Dulsika076/SLIoT-Pathfinder-GTricks/Pathfinder_Base/pcb.jpeg

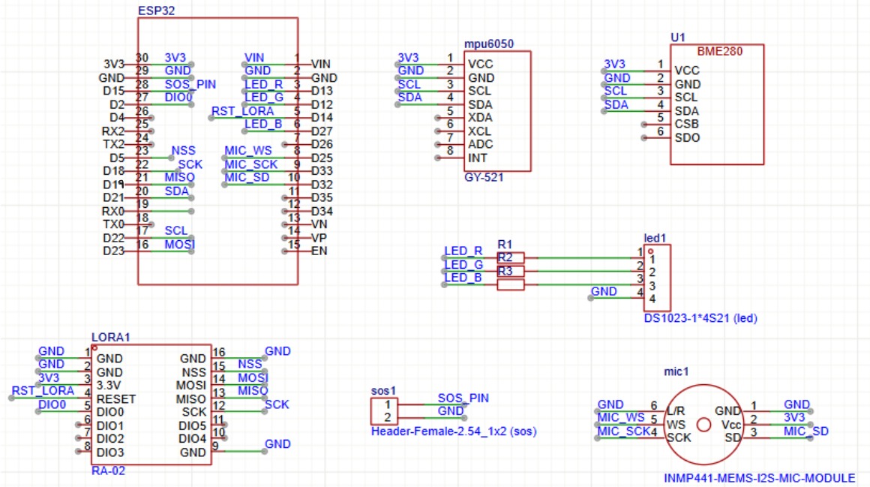
Pathfinder_Base/pcb.jpeg
