Dulsika076/SLIoT-Pathfinder-GTricks/Final/WhatsApp Image 2026-04-24 at 10.30.51 PM (1).jpeg

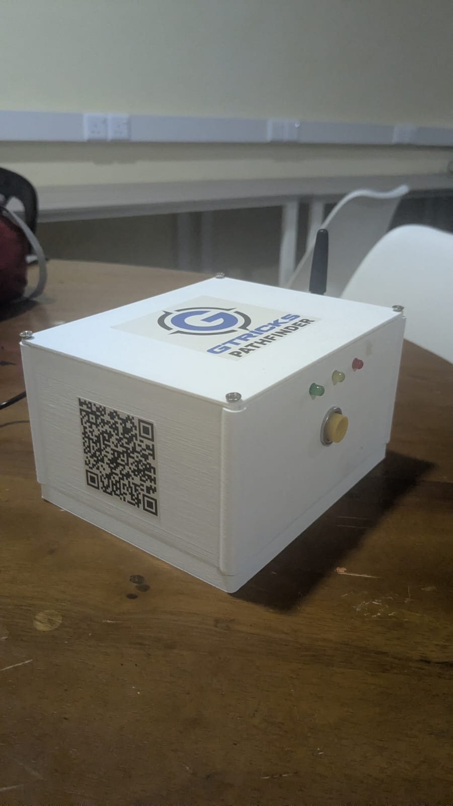
Final/WhatsApp Image 2026-04-24 at 10.30.51 PM (1).jpeg
