Dulsika076/SLIoT-Pathfinder-GTricks/Final/WhatsApp Image 2026-04-24 at 10.30.51 PM.jpeg

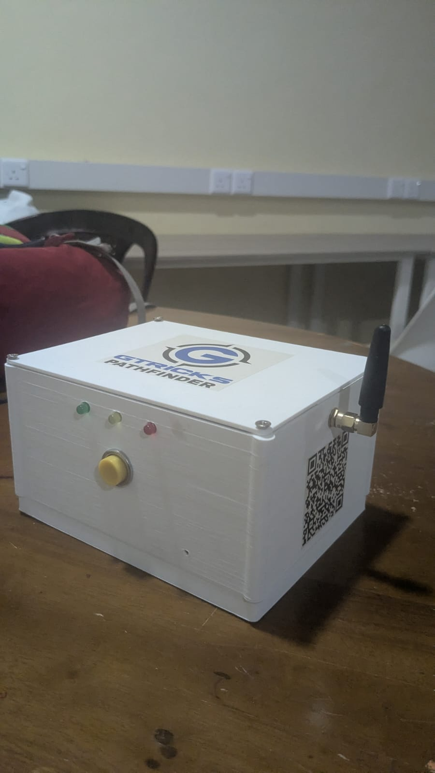
Final/WhatsApp Image 2026-04-24 at 10.30.51 PM.jpeg
