Dulsika076/SLIoT-Pathfinder-GTricks/Final/WhatsApp Image 2026-04-24 at 10.34.52 PM.jpeg

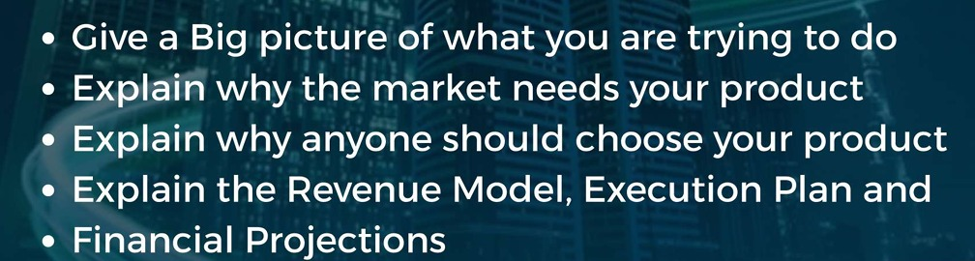
Final/WhatsApp Image 2026-04-24 at 10.34.52 PM.jpeg
