Dulsika076/SLIoT-Pathfinder-GTricks/PCB Design and the Gerber file/PCB_PCB3_2026-07-13.pdf

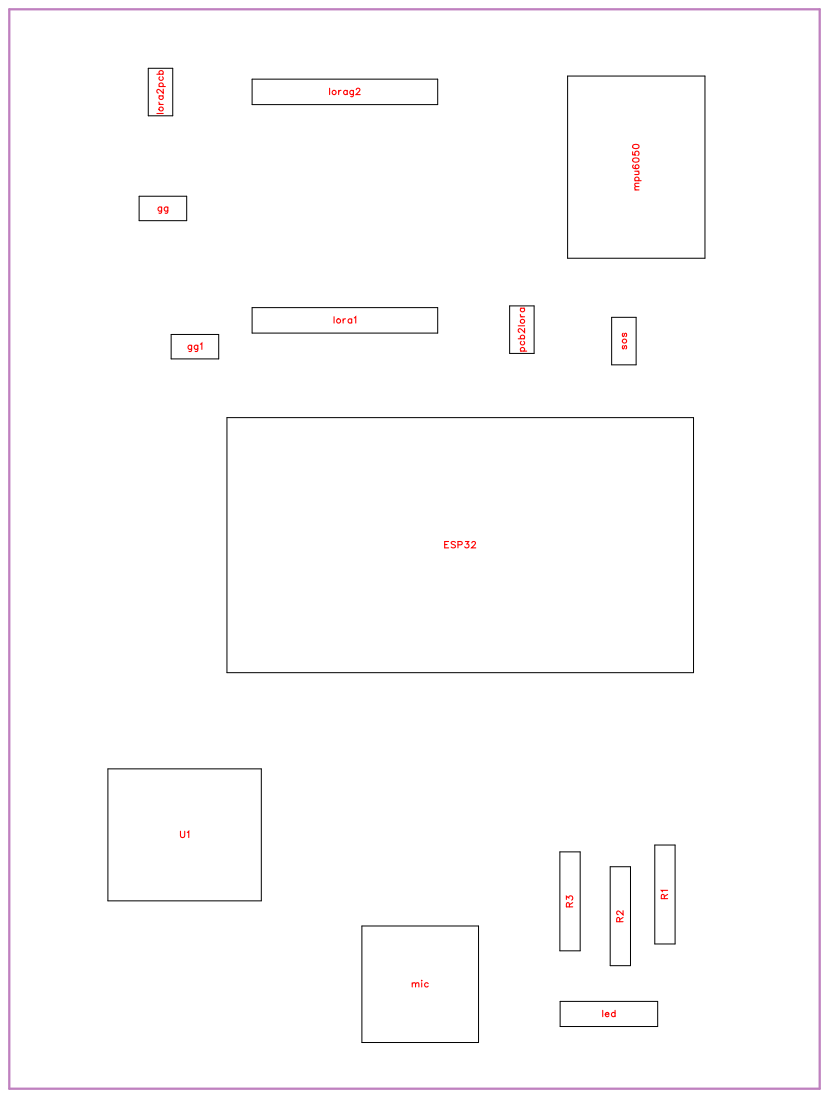
[picture p8: page 1]

No. | Quantity | Comment | Designator | Footprint | Value | Manufacturer Part | Manufacturer | Supplier Part | Supplier
1 | 1 | esp32 doit devkit v1 | ESP32 | DOIT devkit
2 | 5 | Header-Fem ale-2.54_1x2 (sos) | gg,gg1,lora2pcb,pcb2lora,so s | HDR-1X2/2.5 4 | | Header-Fem ale-2.54_1x2 | LCSC | C49661 | LCSC
3 | 1 | DS1023-1*4 S21 (led) | led | HDR-TH_DS 1023-1X4S2 1 | | DS1023-1*4 S21 (led) | CONNFLY | C7423131 | LCSC
4 | 2 | HDR-F-2.54_ 1x8 | lora1,lorag2 | HDR-F-2.54_ 1X8 | | | | C225505 | LCSC
5 | 1 | INMP441-ME MS-I2S-MIC-MODULE | mic | INMP441-ME MS-I2S-MIC-MODULE | | | | | ebay
6 | 1 | GY-521 | mpu6050 | GY-521
7 | 3 | 1206W4F100 2T5E | R1,R2,R3 | Resistor 1/8w 7mm metal film | | 1206W4F100 2T5E | UNI-ROYAL( Uniroyal Elec) | C17902 | LCSC
8 | 1 | BME280 BOB | U1 | BME280 BOB

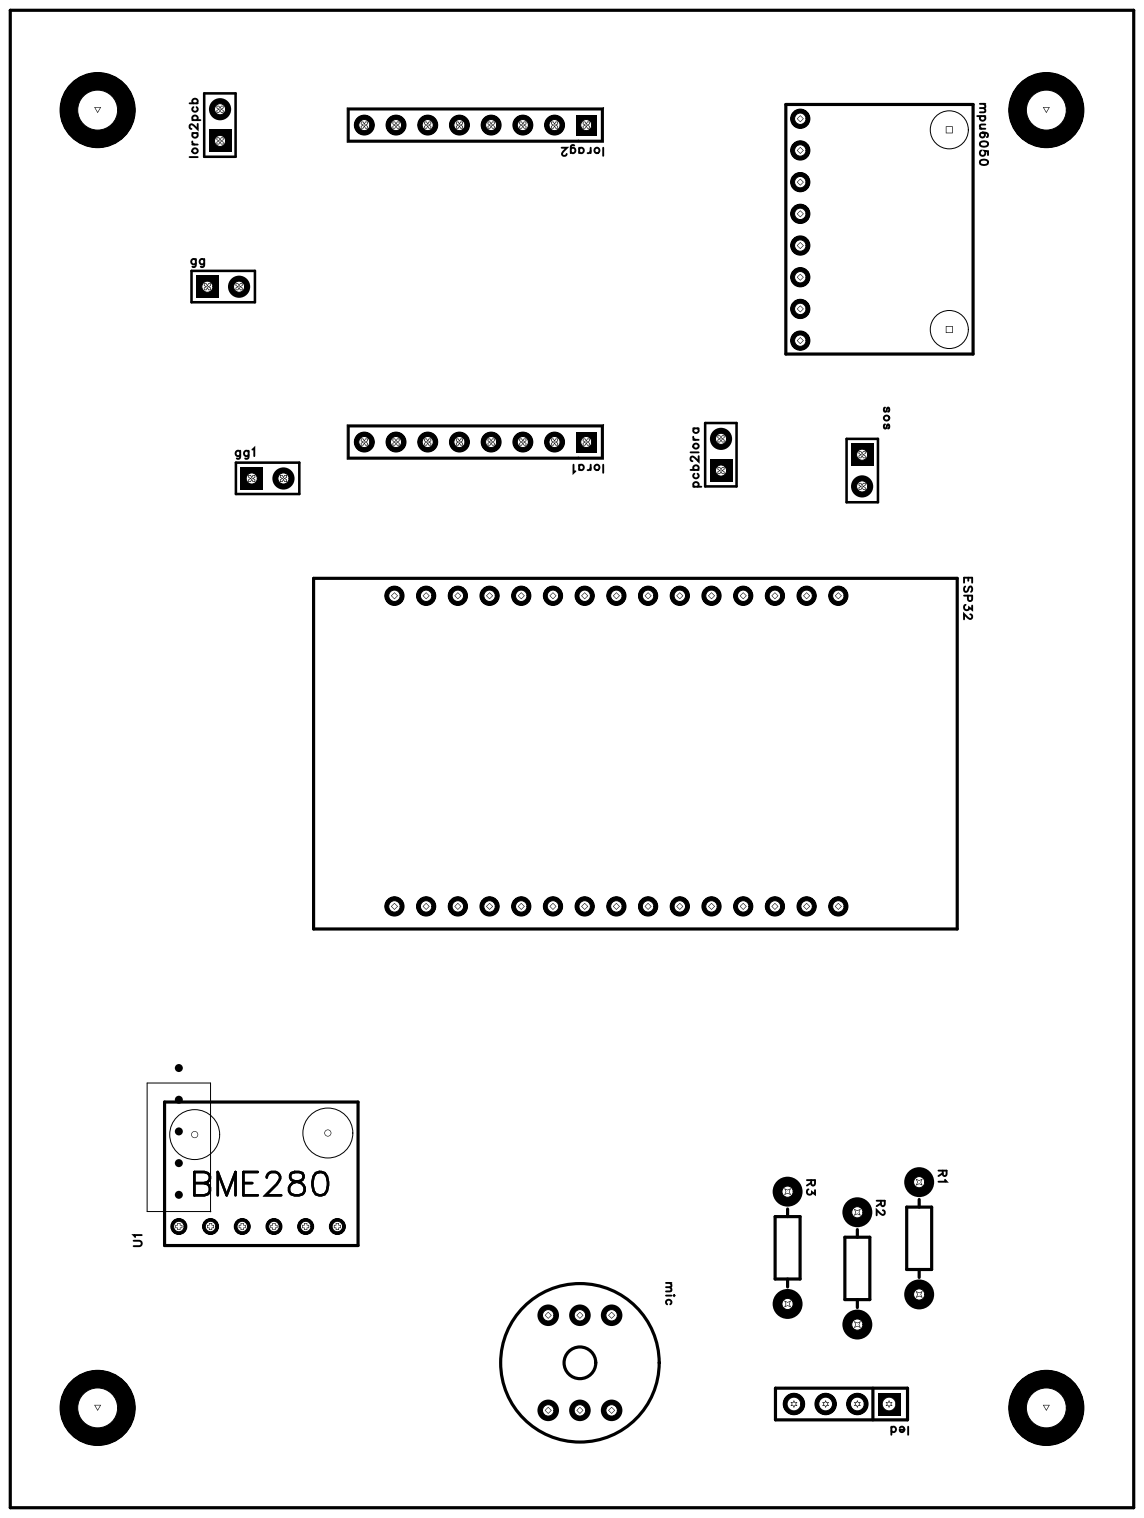
[picture p9: page 4]

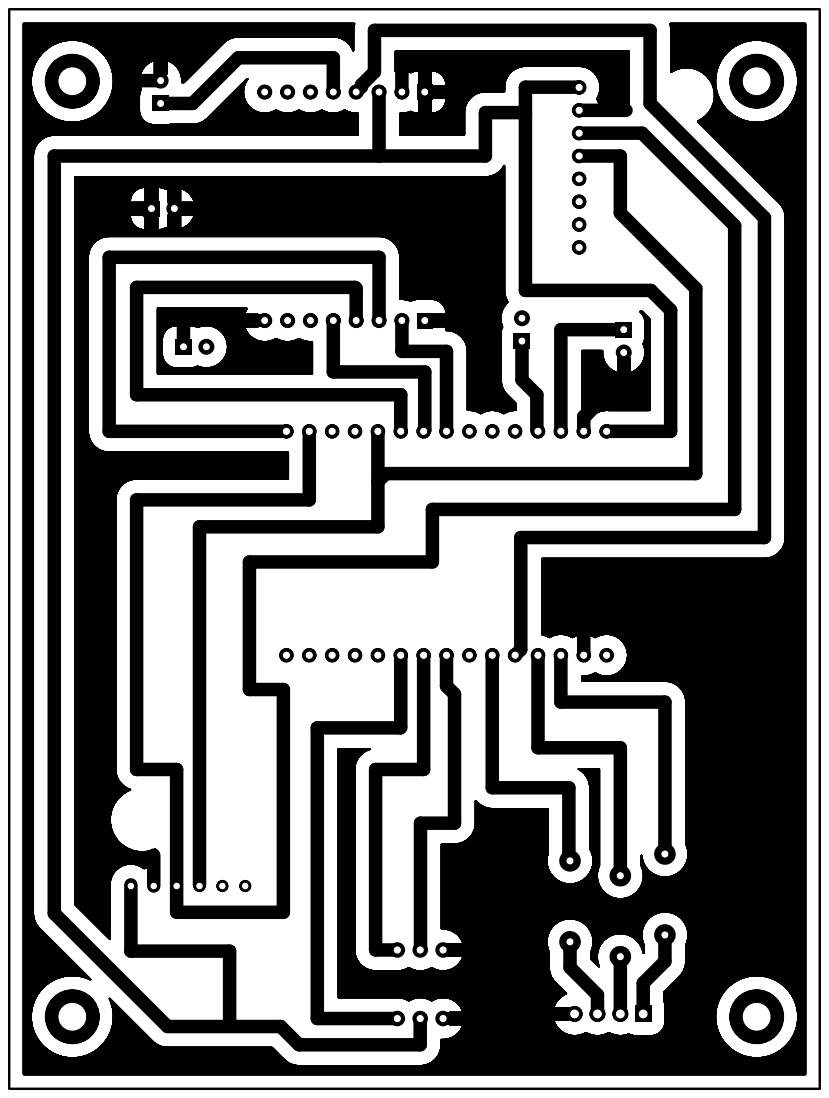
[picture p10: page 5]
